amgibson913/DonCon2040/pcb/DonConIO_SMD/DonConIO_SMD.pdf

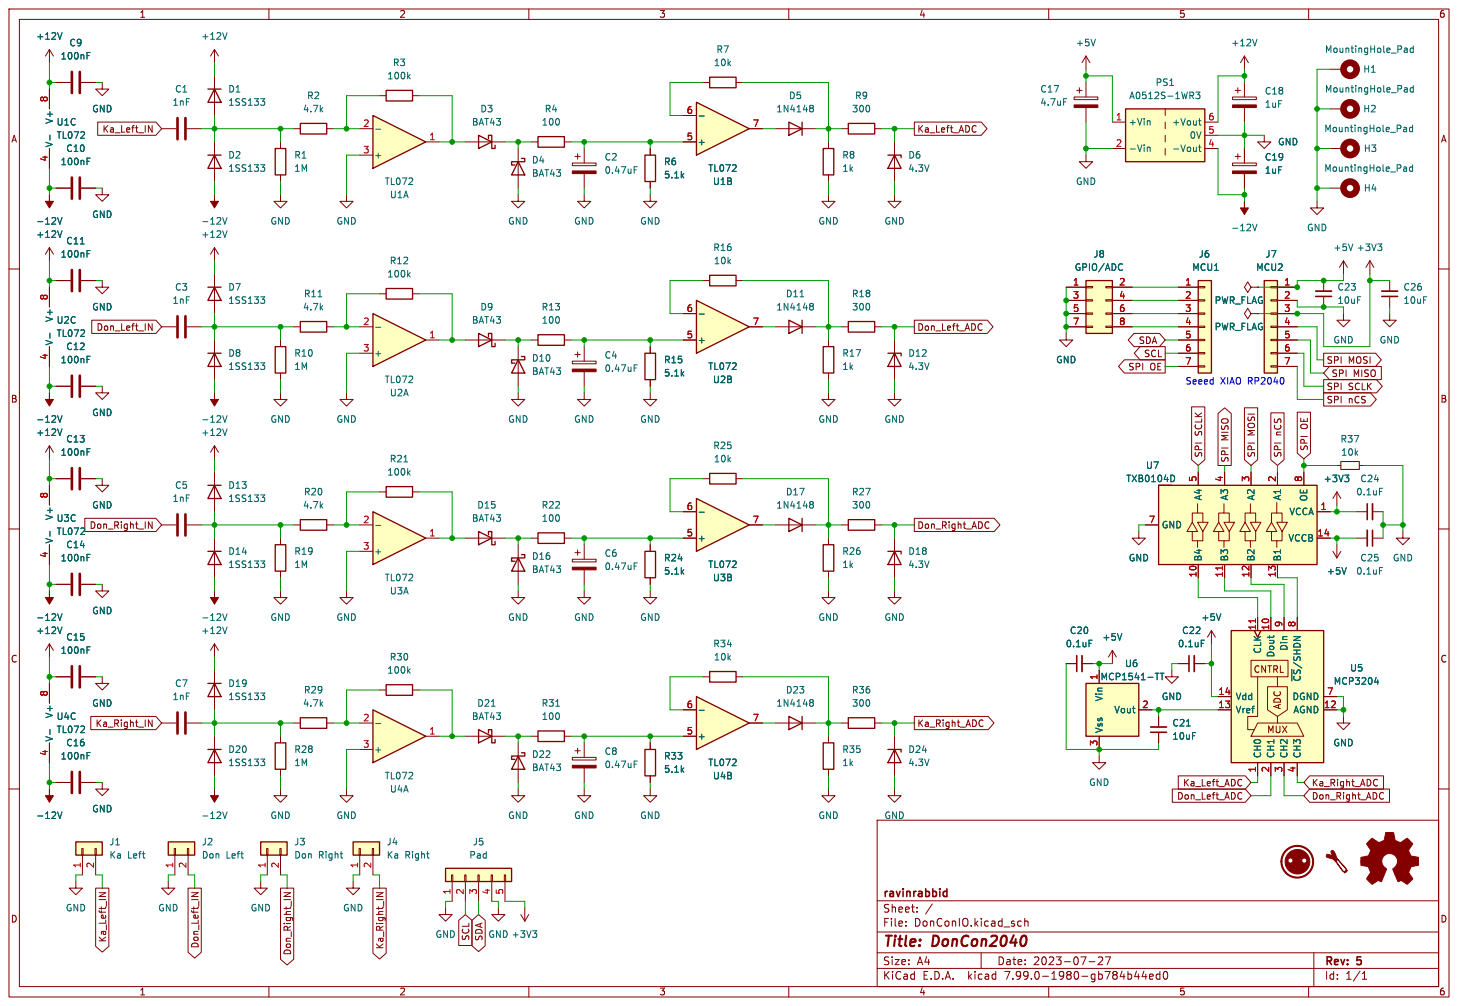
[picture p2: page 1]

SPI MOSI SPI MISO

1 Dout 10 CLK 11 AGND 12 Vref 13 Vdd 14 CH1

File: DonConIO.kicad_sch Sheet: / ravinrabbid
