amgibson913/DonCon2040/pcb/DonConIO_SMD/DonConIO_SMD.kicad_pcb

## KiCad design pcb/DonConIO_SMD/DonConIO_SMD.kicad_pcb (2024-06-10)

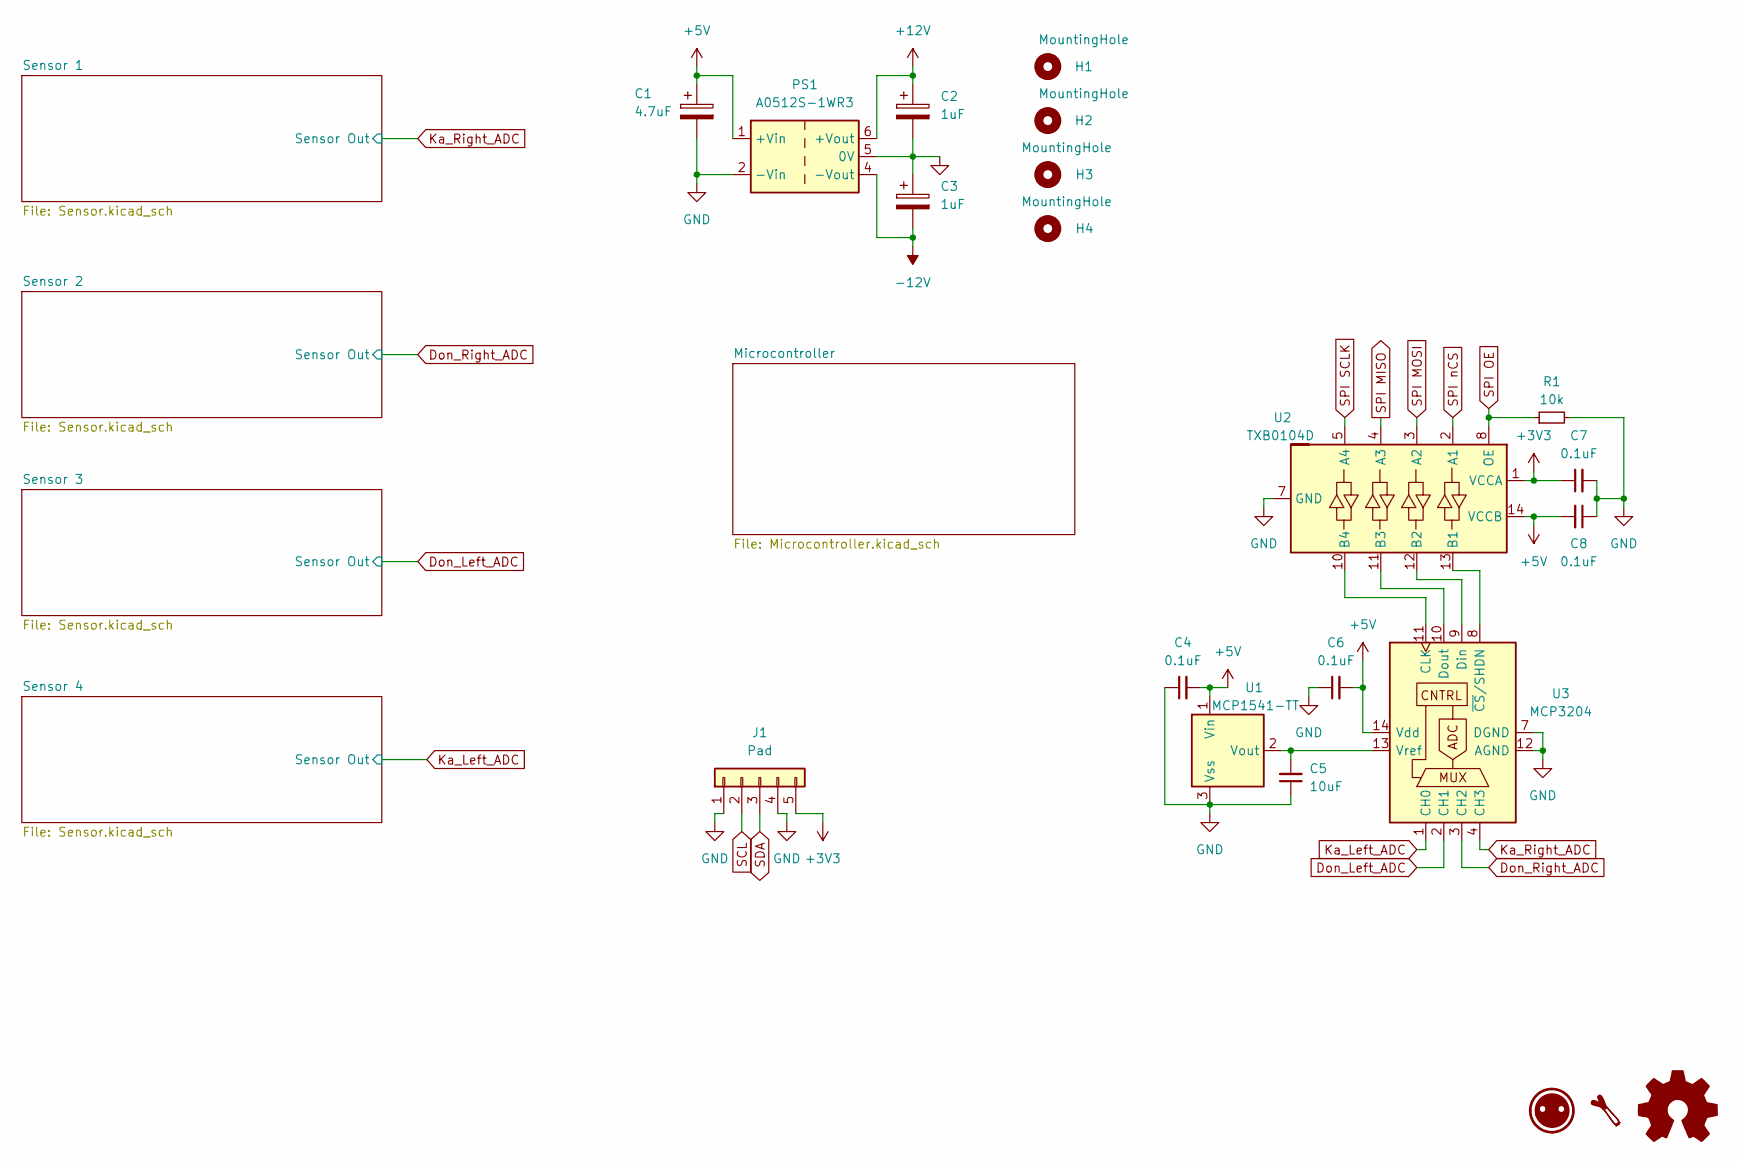
[picture p3: schematic DonConIO_SMD.kicad_sch, DonCon2040_SMD]

Parts:
C1: 4.7uF; C_0603_1608Metric
C2, C3: 1uF; C_0603_1608Metric
C4, C6, C7, C8: 0.1uF; C_0603_1608Metric
C5: 10uF; C_0603_1608Metric
H1, H2, H3, H4: MountingHole; MountingHole_3.2mm_M3
J1: Pad; JST_PH_S5B-PH-K_1x05_P2.00mm_Horizontal
PS1: A0512S-1WR3; Converter_DCDC_XP_POWER-IAxxxxS_THT
R1: 10k; R_0402_1005Metric
U1: MCP1541-TT; SOT-23
U2: TXB0104D; SOIC-14_3.9x8.7mm_P1.27mm
U3: MCP3204; SOIC-14_3.9x8.7mm_P1.27mm

Connections:
+3V3: C7.1, J1.5, U2.1 (VCCA); also elsewhere on the board
+5V: C1.1, C4.2, C6.2, C8.2, PS1.1 (+Vin), U1.1 (Vin), U2.14 (VCCB), U3.14 (Vdd); also elsewhere on the board
+12V: C2.1, PS1.6 (+Vout); also elsewhere on the board
-12V: C3.2, PS1.4 (-Vout); also elsewhere on the board
Don_Left_ADC: U3.2 (CH1); also elsewhere on the board
Don_Right_ADC: U3.3 (CH2); also elsewhere on the board
GND: C1.2, C2.2, C3.1, C4.1, C5.1, C6.1, C7.2, C8.1, J1.1, J1.4, PS1.2 (-Vin), PS1.5 (0V), R1.2, U1.3 (Vss), U2.7 (GND), U3.7 (DGND), U3.12 (AGND); also elsewhere on the board
Ka_Left_ADC: U3.1 (CH0); also elsewhere on the board
Ka_Right_ADC: U3.4 (CH3); also elsewhere on the board
unnamed: C5.2, U1.2 (Vout), U3.13 (Vref)
unnamed: U2.13 (B1), U3.8 (~CS/SHDN)
unnamed: U2.12 (B2), U3.9 (Din)
unnamed: U2.11 (B3), U3.10 (Dout)
unnamed: U2.10 (B4), U3.11 (CLK)
SCL: J1.2; also elsewhere on the board
SDA: J1.3; also elsewhere on the board
SPI MISO: U2.4 (A3); also elsewhere on the board
SPI MOSI: U2.3 (A2); also elsewhere on the board
SPI OE: R1.1, U2.8 (OE); also elsewhere on the board
SPI SCLK: U2.5 (A4); also elsewhere on the board
SPI nCS: U2.2 (A1); also elsewhere on the board

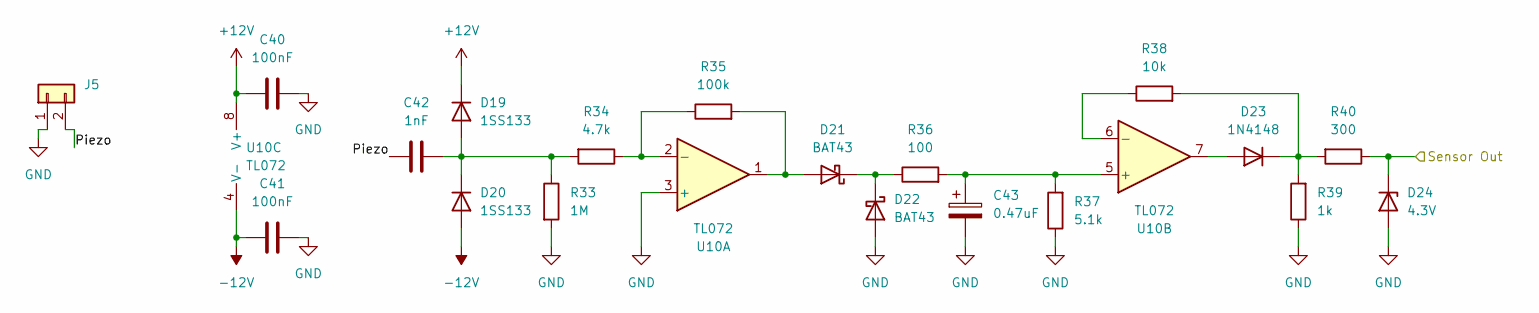
[picture p4: schematic Sensor.kicad_sch]

Parts:
C40, C41: 100nF; C_0402_1005Metric
C42: 1nF; C_0402_1005Metric
C43: 0.47uF; C_0402_1005Metric
D19, D20: 1SS133; D_0402_1005Metric
D21, D22: BAT43; D_0402_1005Metric
D23: 1N4148; D_0402_1005Metric
D24: 4.3V; D_0402_1005Metric
J5: JST; JST_PH_S2B-PH-K_1x02_P2.00mm_Horizontal
R33: 1M; R_0402_1005Metric
R34: 4.7k; R_0402_1005Metric
R35: 100k; R_0402_1005Metric
R36: 100; R_0402_1005Metric
R37: 5.1k; R_0402_1005Metric
R38: 10k; R_0402_1005Metric
R39: 1k; R_0402_1005Metric
R40: 300; R_0402_1005Metric
U10: TL072; SOIC-8_3.9x4.9mm_P1.27mm

Connections:
+12V: C40.1, D19.1 (K), U10.8 (V+); also elsewhere on the board
-12V: C41.1, D20.2 (A), U10.4 (V-); also elsewhere on the board
/Sensor 4/Piezo: C42.1, J5.2
GND: C40.2, C41.2, C43.2, D22.2 (A), D24.2 (A), J5.1, R33.2, R37.1, R39.1, U10.3 (+); also elsewhere on the board
Ka_Left_ADC: D24.1 (K), R40.1; also elsewhere on the board
unnamed: C42.2, D19.2 (A), D20.1 (K), R33.1, R34.2
unnamed: D21.2 (A), R35.2, U10.1
unnamed: D21.1 (K), D22.1 (K), R36.1
unnamed: D23.2 (A), U10.7
unnamed: D23.1 (K), R38.2, R39.2, R40.2
unnamed: R34.1, R35.1, U10.2 (-)
unnamed: C43.1, R36.2, R37.2, U10.5 (+)
unnamed: R38.1, U10.6 (-)

Parts of its further copies:
C28, C29, C32, C33, C36, C37: 100nF; C_0402_1005Metric
C30, C34, C38: 1nF; C_0402_1005Metric
C31, C35, C39: 0.47uF; C_0402_1005Metric
D1, D2, D7, D8, D13, D14: 1SS133; D_0402_1005Metric
D3, D4, D9, D10, D15, D16: BAT43; D_0402_1005Metric
D5, D11, D17: 1N4148; D_0402_1005Metric
D6, D12, D18: 4.3V; D_0402_1005Metric
J2, J3, J4: JST; JST_PH_S2B-PH-K_1x02_P2.00mm_Horizontal
R9, R17, R25: 1M; R_0402_1005Metric
R10, R18, R26: 4.7k; R_0402_1005Metric
R11, R19, R27: 100k; R_0402_1005Metric
R12, R20, R28: 100; R_0402_1005Metric
R13, R21, R29: 5.1k; R_0402_1005Metric
R14, R22, R30: 10k; R_0402_1005Metric
R15, R23, R31: 1k; R_0402_1005Metric
R16, R24, R32: 300; R_0402_1005Metric
U7, U8, U9: TL072; SOIC-8_3.9x4.9mm_P1.27mm

Connections of its further copies:
+12V: C28.1, C32.1, C36.1, D1.1 (K), D7.1 (K), D13.1 (K), U7.8 (V+), U8.8 (V+), U9.8 (V+); also elsewhere on the board
-12V: C29.1, C33.1, C37.1, D2.2 (A), D8.2 (A), D14.2 (A), U7.4 (V-), U8.4 (V-), U9.4 (V-); also elsewhere on the board
/Sensor 1/Piezo: C30.1, J2.2
/Sensor 2/Piezo: C34.1, J3.2
/Sensor 3/Piezo: C38.1, J4.2
Don_Left_ADC: D18.1 (K), R32.1; also elsewhere on the board
Don_Right_ADC: D12.1 (K), R24.1; also elsewhere on the board
GND: C28.2, C29.2, C31.2, C32.2, C33.2, C35.2, C36.2, C37.2, C39.2, D4.2 (A), D6.2 (A), D10.2 (A), D12.2 (A), D16.2 (A), D18.2 (A), J2.1, J3.1, J4.1, R9.2, R13.1, R15.1, R17.2, R21.1, R23.1, R25.2, R29.1, R31.1, U7.3 (+), U8.3 (+), U9.3 (+); also elsewhere on the board
Ka_Right_ADC: D6.1 (K), R16.1; also elsewhere on the board
unnamed: C30.2, D1.2 (A), D2.1 (K), R9.1, R10.2
unnamed: D3.2 (A), R11.2, U7.1
unnamed: D3.1 (K), D4.1 (K), R12.1
unnamed: D5.2 (A), U7.7
unnamed: D5.1 (K), R14.2, R15.2, R16.2
unnamed: C34.2, D7.2 (A), D8.1 (K), R17.1, R18.2
unnamed: D9.2 (A), R19.2, U8.1
unnamed: D9.1 (K), D10.1 (K), R20.1
unnamed: D11.2 (A), U8.7
unnamed: D11.1 (K), R22.2, R23.2, R24.2
unnamed: C38.2, D13.2 (A), D14.1 (K), R25.1, R26.2
unnamed: D15.2 (A), R27.2, U9.1
unnamed: D15.1 (K), D16.1 (K), R28.1
unnamed: D17.2 (A), U9.7
unnamed: D17.1 (K), R30.2, R31.2, R32.2
unnamed: R10.1, R11.1, U7.2 (-)
unnamed: C31.1, R12.2, R13.2, U7.5 (+)
unnamed: R14.1, U7.6 (-)
unnamed: R18.1, R19.1, U8.2 (-)
unnamed: C35.1, R20.2, R21.2, U8.5 (+)
unnamed: R22.1, U8.6 (-)
unnamed: R26.1, R27.1, U9.2 (-)
unnamed: C39.1, R28.2, R29.2, U9.5 (+)
unnamed: R30.1, U9.6 (-)

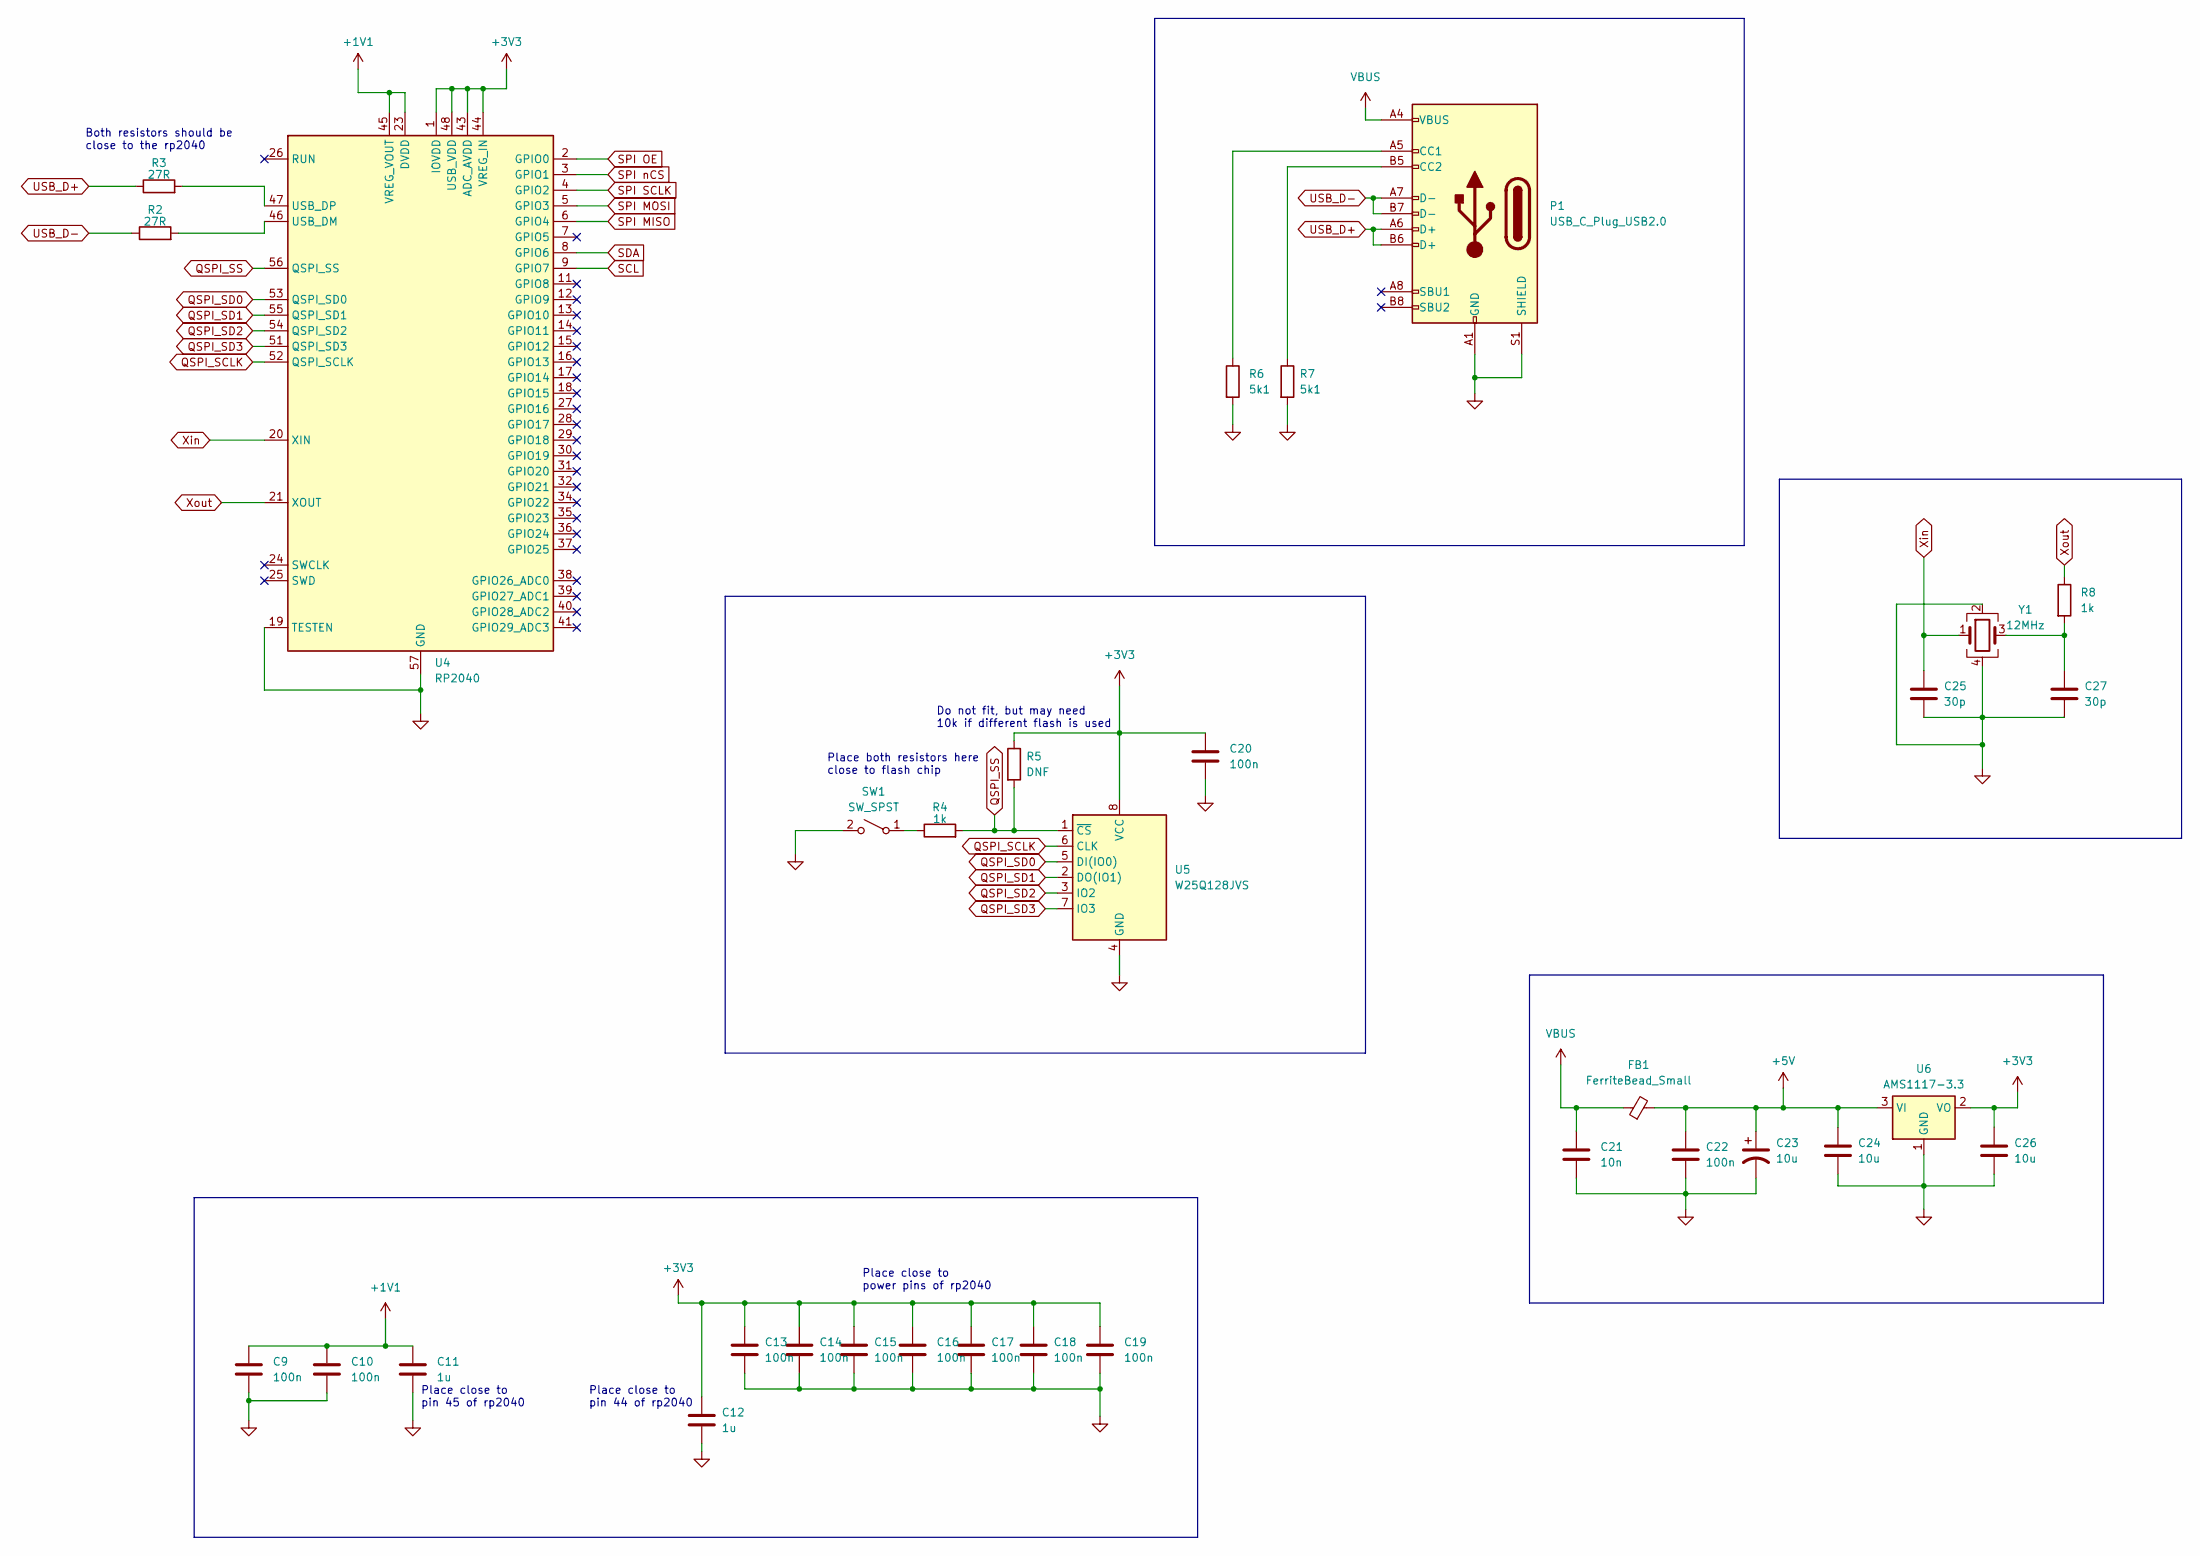
[picture p5: schematic Microcontroller.kicad_sch]

Parts:
C9, C10, C13, C14, C15, C16, C17, C18, C19, C20, C22: 100n; C_0402_1005Metric; MPN C1525
C11, C12: 1u; C_0603_1608Metric; MPN C15849
C21: 10n; C_0402_1005Metric; MPN C15195
C23: 10u; CP_EIA-3216-10_Kemet-I; MPN C7171
C24, C26: 10u; C_0805_2012Metric; MPN C15850
C25, C27: 30p; C_0402_1005Metric; MPN C1570
FB1: FerriteBead_Small; L_0805_2012Metric; MPN C1015
P1: USB_C_Plug_USB2.0; USB_C_Receptacle_G-Switch_GT-USB-7010ASV; MPN C2988369
R2, R3: 27R; R_0603_1608Metric; MPN C25190
R4, R8: 1k; R_0402_1005Metric; MPN C11702
R5: DNF; R_0402_1005Metric
R6, R7: 5k1; R_0402_1005Metric; MPN C25905
SW1: SW_SPST; SW_Push_1P1T_XKB_TS-1187A; MPN C318884
U4: RP2040; QFN-56-1EP_7x7mm_P0.4mm_EP3.2x3.2mm; MPN C2040
U5: W25Q128JVS; SOIC-8_5.23x5.23mm_P1.27mm; MPN C97521
U6: AMS1117-3.3; SOT-223-3_TabPin2; MPN C6186
Y1: 12MHz; Crystal_SMD_3225-4Pin_3.2x2.5mm; MPN C9002

Connections:
+1V1: C9.1, C10.1, C11.1, U4.23 (DVDD), U4.45 (VREG_VOUT), U4.50 (DVDD)
+3V3: C12.1, C13.1, C14.1, C15.1, C16.1, C17.1, C18.1, C19.1, C20.1, C26.1, R5.1, U4.1 (IOVDD), U4.10 (IOVDD), U4.22 (IOVDD), U4.33 (IOVDD), U4.42 (IOVDD), U4.43 (ADC_AVDD), U4.44 (VREG_IN), U4.48 (USB_VDD), U4.49 (IOVDD), U5.8 (VCC), U6.2 (VO); also elsewhere on the board
+5V: C22.1, C23.1, C24.1, FB1.2, U6.3 (VI); also elsewhere on the board
GND: C9.2, C10.2, C11.2, C12.2, C13.2, C14.2, C15.2, C16.2, C17.2, C18.2, C19.2, C20.2, C21.2, C22.2, C23.2, C24.2, C25.2, C26.2, C27.2, P1.A1 (GND), P1.A12 (GND), P1.B1 (GND), P1.B12 (GND), P1.S1 (SHIELD), R6.2, R7.2, SW1.2 (B), U4.19 (TESTEN), U4.57 (GND), U5.4 (GND), U6.1 (GND), Y1.2, Y1.4; also elsewhere on the board
unnamed: C27.1, R8.2, Y1.3
unnamed: P1.A5 (CC1), R6.1
unnamed: P1.B5 (CC2), R7.1
unnamed: R4.1, SW1.1 (A)
unnamed: R2.2, U4.46 (USB_DM)
unnamed: R3.2, U4.47 (USB_DP)
QSPI_SCLK: U4.52 (QSPI_SCLK), U5.6 (CLK)
QSPI_SD0: U4.53 (QSPI_SD0), U5.5 (DI(IO0))
QSPI_SD1: U4.55 (QSPI_SD1), U5.2 (DO(IO1))
QSPI_SD2: U4.54 (QSPI_SD2), U5.3 (IO2)
QSPI_SD3: U4.51 (QSPI_SD3), U5.7 (IO3)
QSPI_SS: R4.2, R5.2, U4.56 (QSPI_SS), U5.1 (~CS)
SCL: U4.9 (GPIO7); also elsewhere on the board
SDA: U4.8 (GPIO6); also elsewhere on the board
SPI MISO: U4.6 (GPIO4); also elsewhere on the board
SPI MOSI: U4.5 (GPIO3); also elsewhere on the board
SPI OE: U4.2 (GPIO0); also elsewhere on the board
SPI SCLK: U4.4 (GPIO2); also elsewhere on the board
SPI nCS: U4.3 (GPIO1); also elsewhere on the board
USB_D+: P1.A6 (D+), P1.B6 (D+), R3.1
USB_D-: P1.A7 (D-), P1.B7 (D-), R2.1
VBUS: C21.1, FB1.1, P1.A4 (VBUS), P1.A9 (VBUS), P1.B4 (VBUS), P1.B9 (VBUS)
Xin: C25.1, U4.20 (XIN), Y1.1
Xout: R8.1, U4.21 (XOUT)

Notes on the sheet:
Place both resistors here close to flash chip
Place close to power pins of rp2040
Do not fit, but may need 10k if different flash is used
Place close to pin 44 of rp2040
Both resistors should be close to the rp2040
Place close to pin 45 of rp2040

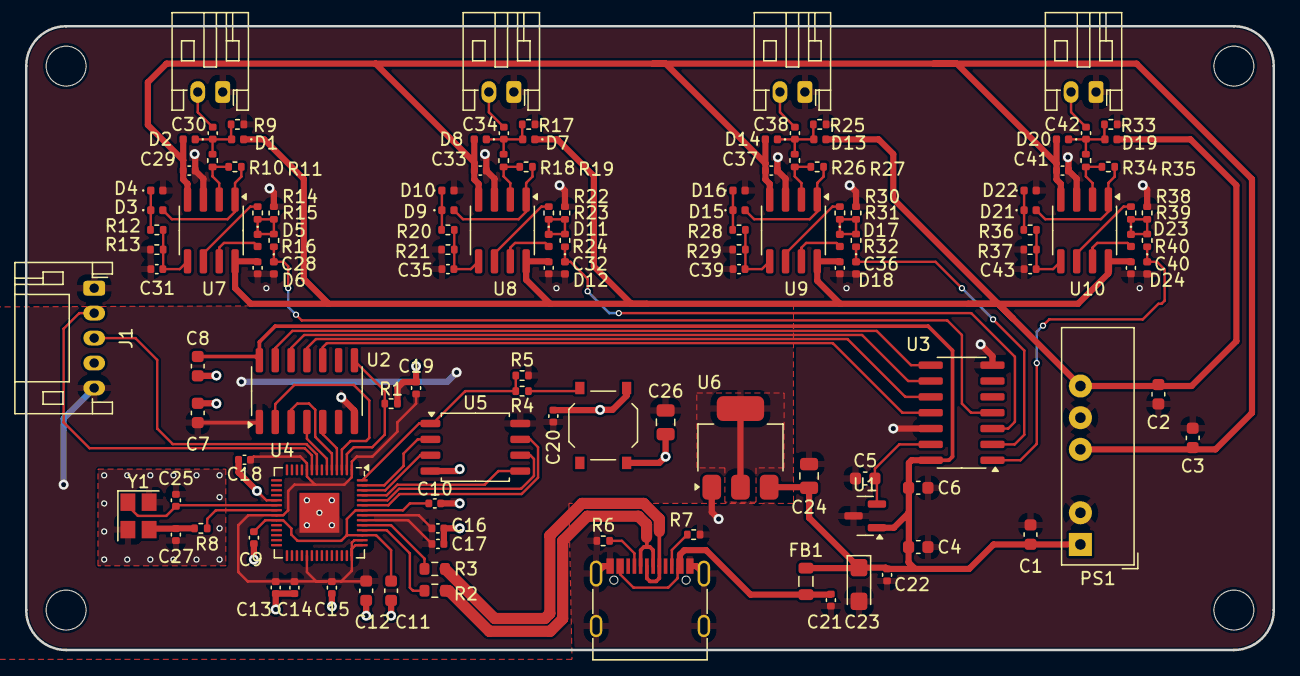
[picture p6: board DonConIO_SMD.kicad_pcb from above]

Board: 2 copper layers, 100.0 x 50.0 mm, 131 parts (0 on the bottom side), 75 nets.
